yzsnow/26NUEDC-H/m0g3507小车底盘/流程图/底盘项目软件总流程图.png

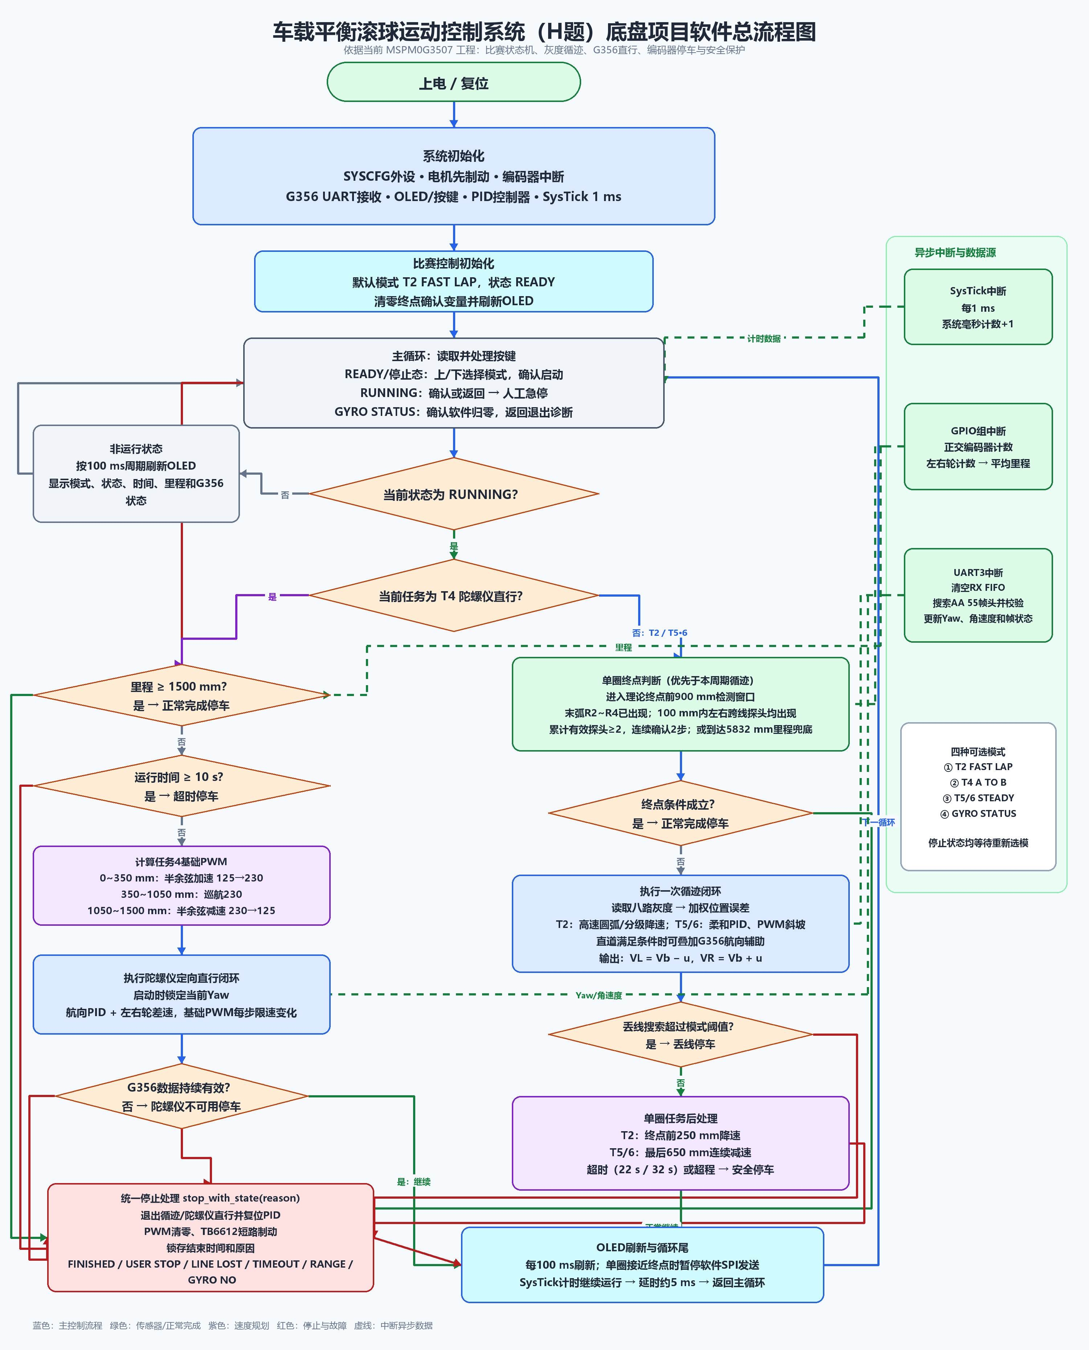
m0g3507小车底盘/流程图/底盘项目软件总流程图.png
